Power-Electronics-PCBs-and-Stuff/Wireless-Power-Synchronous-Rectifier/README.md

# Wireless-Power-Synchronous-Rectifier

A 250 kHz wireless-power receiver with a PLL-controlled GaN synchronous rectifier, designed in KiCad 10.
Target output: **67 V / 10 A (~670 W)** into the XT60 output.

> **Status: design in progress — not validated for power operation.** See [Open items](#open-items).

The architecture follows the matched-delay-chain PLL synchronous rectifier described in
*"A Phase-Locked Loop based Multi-MHz Synchronous Rectifier with Inherent Delay Cancellation and ZVS Control"*
(APEC 2027), scaled from the paper's 6.78 MHz prototype down to 250 kHz.

## How it works

1. **Receiver tank** — the receiver coil is series-tuned by C1, C58 and C47. C47 (1 µF) doubles as the
   current-sense capacitor.
2. **Capacitive current sensing** — the voltage across C47 lags the coil current by 90°; the OPA656
   differential integrator (Rf‖Cf = 470k‖68p) adds another −90°, so its output `Is` is in phase with the
   coil current. U3 (TLV3601) squares it into `Is_square`.
3. **PLL** — the SN74LV4046A phase-frequency detector (PC2) compares `Is_square` with `COMPIN` and steers
   the VCO through the R22/R20/C15 loop filter. The VCO output (`pwm`) drives the bridge.
4. **Matched delay chain** — `pwm` drives the real gate drivers (two Si8274GB1) *and* an identical
   "virtual" Si8274GB1 (U1) whose VOB output is squared by a second TLV3601 (U2) into `COMPIN`. Because the
   feedback path uses the same parts as the forward path, their propagation delays cancel.
5. **Synchronous bridge** — four EPC2305 150 V GaN FETs (Q1–Q4) in a full bridge replace the rectifier
   diodes. Output capacitance ≈ 1000 µF.

## Schematic blocks

| Block | Key parts |
|---|---|
| AC input | ReceiverCoil1 (screw terminal), C1/C58 33 nF tuning, C47 1 µF sense cap |
| Rectifier | Q1–Q4 EPC2305 (Q1/Q2 = S1 leg, Q3/Q4 = S2 leg), C19/C27 500 µF bulk, C28–C30/C54 4.7 µF, TP19/22/34–37 |
| Is Ground_Ref (current sense) | IC3 OPA656, 3 × 22k input chains, R43/R44 1k, R45/R46 470k, C4/C5 68p |
| VC comparator | U3 TLV3601, C11 100 nF coupling, 10k bias |
| VCO / PLL | VCO1 SN74LV4046A, C14 2.7 nF, R18 33.2k, R19 6.81k, loop filter R22/R20 3.3k + C15 180 nF |
| S1 / S2 gate drivers | Si8274GB1-IS1R ×2 (single PWM input), 74AHCT1G86 XOR inputs, BAT46W bootstrap diodes, D5/D6 5V1 Zener clamps, R28/R29 15k ‖ 100p dead time (≈38 ns), 3.2 Ω gate resistors |
| Phase shift for COMPIN | U1 Si8274GB1 virtual gate driver (minimum dead time: R7 6.04k ‖ 100p ≈ 20 ns), R10 |
| Feedback to COMPIN | U2 TLV3601 |
| −5 V rail | IC2 LM2776 charge-pump inverter |
| 5 V battery input | BT1 4×AA holder (BC4AAB) → U4 TPS7A2550 5.0 V LDO (C16 1 µF in, C26 2.2 µF out), D3 power LED |
| XT60 output | J1 XT60PW, D4 output-live LED with R13 (doubles as a bleeder for the output caps) |

## Nets to know

| Net | Meaning |
|---|---|
| `S1`, `S2` | Bridge switch nodes (AC input to the rectifier) |
| `Out+` | Rectified DC output |
| `G1`–`G4` | Gate drive for Q1–Q4 |
| `Is`, `Is_square` | Sensed coil current (analog / squared) |
| `FB`, `COMPIN` | Virtual-driver feedback into the PLL |
| `pwm`, `CTRL` | VCO output / VCO control voltage |
| `5V`, `-5V` | Logic rails |

## Libraries

Project-specific symbols and footprints are in `libs/`. Register each in KiCad
(**Preferences → Manage Symbol / Footprint Libraries**), using the folder name as the nickname:

| Part | Symbol | Footprint |
|---|---|---|
| EPC2305 GaN FET | `libs/EPC2305.kicad_sym` | `libs/EPC2305.pretty` |
| TPS7A2550 LDO | `libs/TPS7A25550DRVR.kicad_sym` | `libs/TPS7A25550DRVR.pretty` |
| XT60PW connector | `libs/XT60PW-M.kicad_sym` | `libs/XT60PW-M.pretty` |
| BC4AAB battery holder | `libs/BC4AAB.kicad_sym` | `libs/BC4AAB.pretty` |
| LM2776 | `libs/LM2776DBVR.kicad_sym` | `libs/LM2776DBVR.pretty` |
| Si8274GB1-IS1R gate driver | `libs/SI8274GB1-IS1R.kicad_sym` | stock `Package_SO:SOIC-16_3.9x9.9mm_P1.27mm` |

The EPC2305 symbol is the 15-pin vendor version: all `G_x` pins are the gate, `S_x` the source and
`D_x` the drain (datasheet pads 1 = G, 2/4/6 = S, 3/5/7 = D).

Resistor footprints: 0603 for signal parts; 1206 for parts with high voltage or power across them
(R13 output LED, and the gate resistors if gate drive is raised).

## Open items

- **VCO tuning** — C14/R18/R19 are scaled from the original 13.56 MHz design. Per the CD74HC4046A
  tuning curves, R19 = 6.81k fixes the VCO floor near 600 kHz, so the PLL cannot lock at 250 kHz.
  Proposed values: R19 → 20k, R18 → 13.7k (C14 stays 2.7 nF), loop filter R22 → 9.1k, R20 → 680 Ω,
  C15 → 470 nF. Verify open-loop (step `CTRL` 1.1–4.1 V) before finalizing.
- **Dead time / ZVS** — Si8274 dead time is DT(ns) = 2.02 × R_DT(kΩ) + 7.77, with R_DT 6k–100k. The real
  drivers use 15k (≈38 ns) and the virtual driver 6.04k (≈20 ns); the difference is the paper's ZVS phase
  lead. With the EPC2305's ~103 nC output charge, tune R28/R29 on the bench.
- **Gate drive** — the Si8274 outputs swing to VDDA/VDDB (5 V rail; bootstrap ≈ 4.6 V). It has no internal
  gate clamp, so D5/D6 (5V1 Zener) clamp the bootstrap supply. The EPC2305 gate is rated +6 / −4 V max.
- **Gate pull-downs** — add 10k gate-to-source resistors on Q1–Q4.
- **Comparator bias** — feed U3's + input from the 2.5 V reference (single divider) to remove divider
  mismatch at light load.
- **Receiver interface** — coil inductance assumed 24.68 µH; C1/C58 = 33 nF tune to ~251.5 kHz with
  C47 = 1 µF. Coil and tuning capacitors see ~600 V / ~300 V peak at full load; tuning caps must be
  low-loss film or C0G banks rated for ~11 A RMS. Consider splitting C1/C58 across both coil terminals.
- **Battery** — 4×AA keeps the LDO in regulation only while the pack is above ~5.1 V; 6×AA or a
  buck-boost covers the full discharge.
- **ERC** — remaining errors predate the EPC2305 update (unconnected pins, undriven power pins, missing
  PWR_FLAGs); resolve before layout. R11/R13 still need footprints; set D3/D4 part numbers.
- **PCB** — not started.

## PCB status (2026-11-06)

Update 2026-11-08 (v32, sample cap placement): the S1 tank caps now sit as in `Sample/SynchRectifier_v3`: C58 stacked over
C1 directly above the S1 island with a 4.2 mm pad-to-pad copper zone between them and a 3.4 mm link straight down into the
island; the coil lug moved 6 mm up (board 151 x 83.6 mm). C47 above the S2 copper, the four 4.7 uF bridge caps under the FET
columns on the bottom side, and the driver decoupling directly over/beside the drivers already matched the sample. PLL
passives in two columns beside the 4046 (sample style). KiCad DRC 0/0, 150 vias.

Update 2026-11-08 (v31, clean-up pass): control section re-placed in aligned rows/columns (sense strings in two rows of
four over the OPA656, its bias network in one row, comparator U3 and LDO blocks with their passives in rows, PLL passives in
one bottom-side row under the 4046, U1's passives in one column, test points in rows below the bridge and along the bottom
edge). 5V pads now share one via per decoupling cluster instead of one via per pad (5V vias 40 -> 17, total 188 -> 160);
layer changes cost more in the router. KiCad DRC: 0 violations, 0 unconnected.

Update 2026-11-08 (v30): board shrunk to 151 x 77.6 mm (bottom edge raised, XT60 J1 moved to the left edge next to the
bulk caps, battery holder moved up). The four 4.7 uF bridge caps sit on the bottom side directly under the two FET
columns (two per half bridge) on a dedicated Out+ pour (B/In1/In2) with GND vias beside them. Every signal test point has
a GND test point 3.2 mm away (two pairs share a ground, the G2 pair is 4.3 mm). Routed track corners are mitred to 45 deg
(13 of ~500 corners stay at 90 deg where a mitre would break 0.2 mm clearance). `tools/pcb_build/current_check.py`
tabulates the copper cross-section / IPC-2221 ampacity of every power path (Out+ >= 20 A at 20 degC rise everywhere,
tank >= 16 A except the 2.5 mm C47->S2 link at 20.7 A); `pair_check.py` reports pair lengths, right angles and cap
orientation. KiCad DRC on v30: 0 violations, 0 unconnected (the two vendor footprints were repaired in `libs/`:
IC2 DBV0006A_N centre-cross moved from F.CrtYd to F.Fab, U4 DRV0006A-IPC_A thermal pad 1.1 -> 1.0 mm; vendor '*' and
'Designator' silkscreen texts moved to the Fab layer; R46/C62 designators hidden because no collision-free spot exists).

Update 2026-11-08 (v29): decoupling and bootstrap caps are now placed by `build_pcb.py` against their IC supply pins
(`place_near` / `place_between`, same side as the IC where possible, 1.3-2.5 mm pad-to-pin for the drivers, comparator,
LDO and charge pump; the two Si8274 bootstrap caps straddle VDDA/VSSA with fixed stubs). KiCad DRC unchanged otherwise.

Initial layout generated by `tools/pcb_build/` (see its README): 4 layers, 2 oz outer copper, 151 x 98 mm,
modelled on `Sample/SynchRectifier_v3`. GND pour on all layers except the input/power block, where only targeted
GND islands exist (S1 driver area, low-side FET sources with the 4.7 uF decoupling caps); S1 / S2 / Out+ copper
islands with via arrays under the EPC2305 bridge; 5 mm tank copper; Out+ bus down the left edge to the XT60.
KiCad DRC: 0 unconnected; remaining items are silkscreen text, two library-footprint problems (U4 DRV pad gap,
IC2 open courtyard) and the J1 edge placement (intentional).

Still to do on the PCB: via-in-pad for the EPC2305 bars (fab-dependent), replace the single 1206 tank caps with
the real cap bank and redo that copper, silkscreen cleanup, fix the two footprints, review the kicad-happy EMC
notes (reference-plane gaps are a consequence of the notched GND pour).

## Simulation

LTspice models of the sense chain (`_p1`) and the PLL/VCO loop (`_p2`) are kept in the
`v3_Rectifier_Sims` folder. The p2 model uses a 74HC4046 model as a proxy for the SN74LV4046A; keep the
bridge gates disabled until the PLL locks when simulating.
