Power-Electronics-PCBs-and-Stuff/Wireless-Power-Synchronous-Rectifier/Schematic/Synchronous Rectifier.pdf

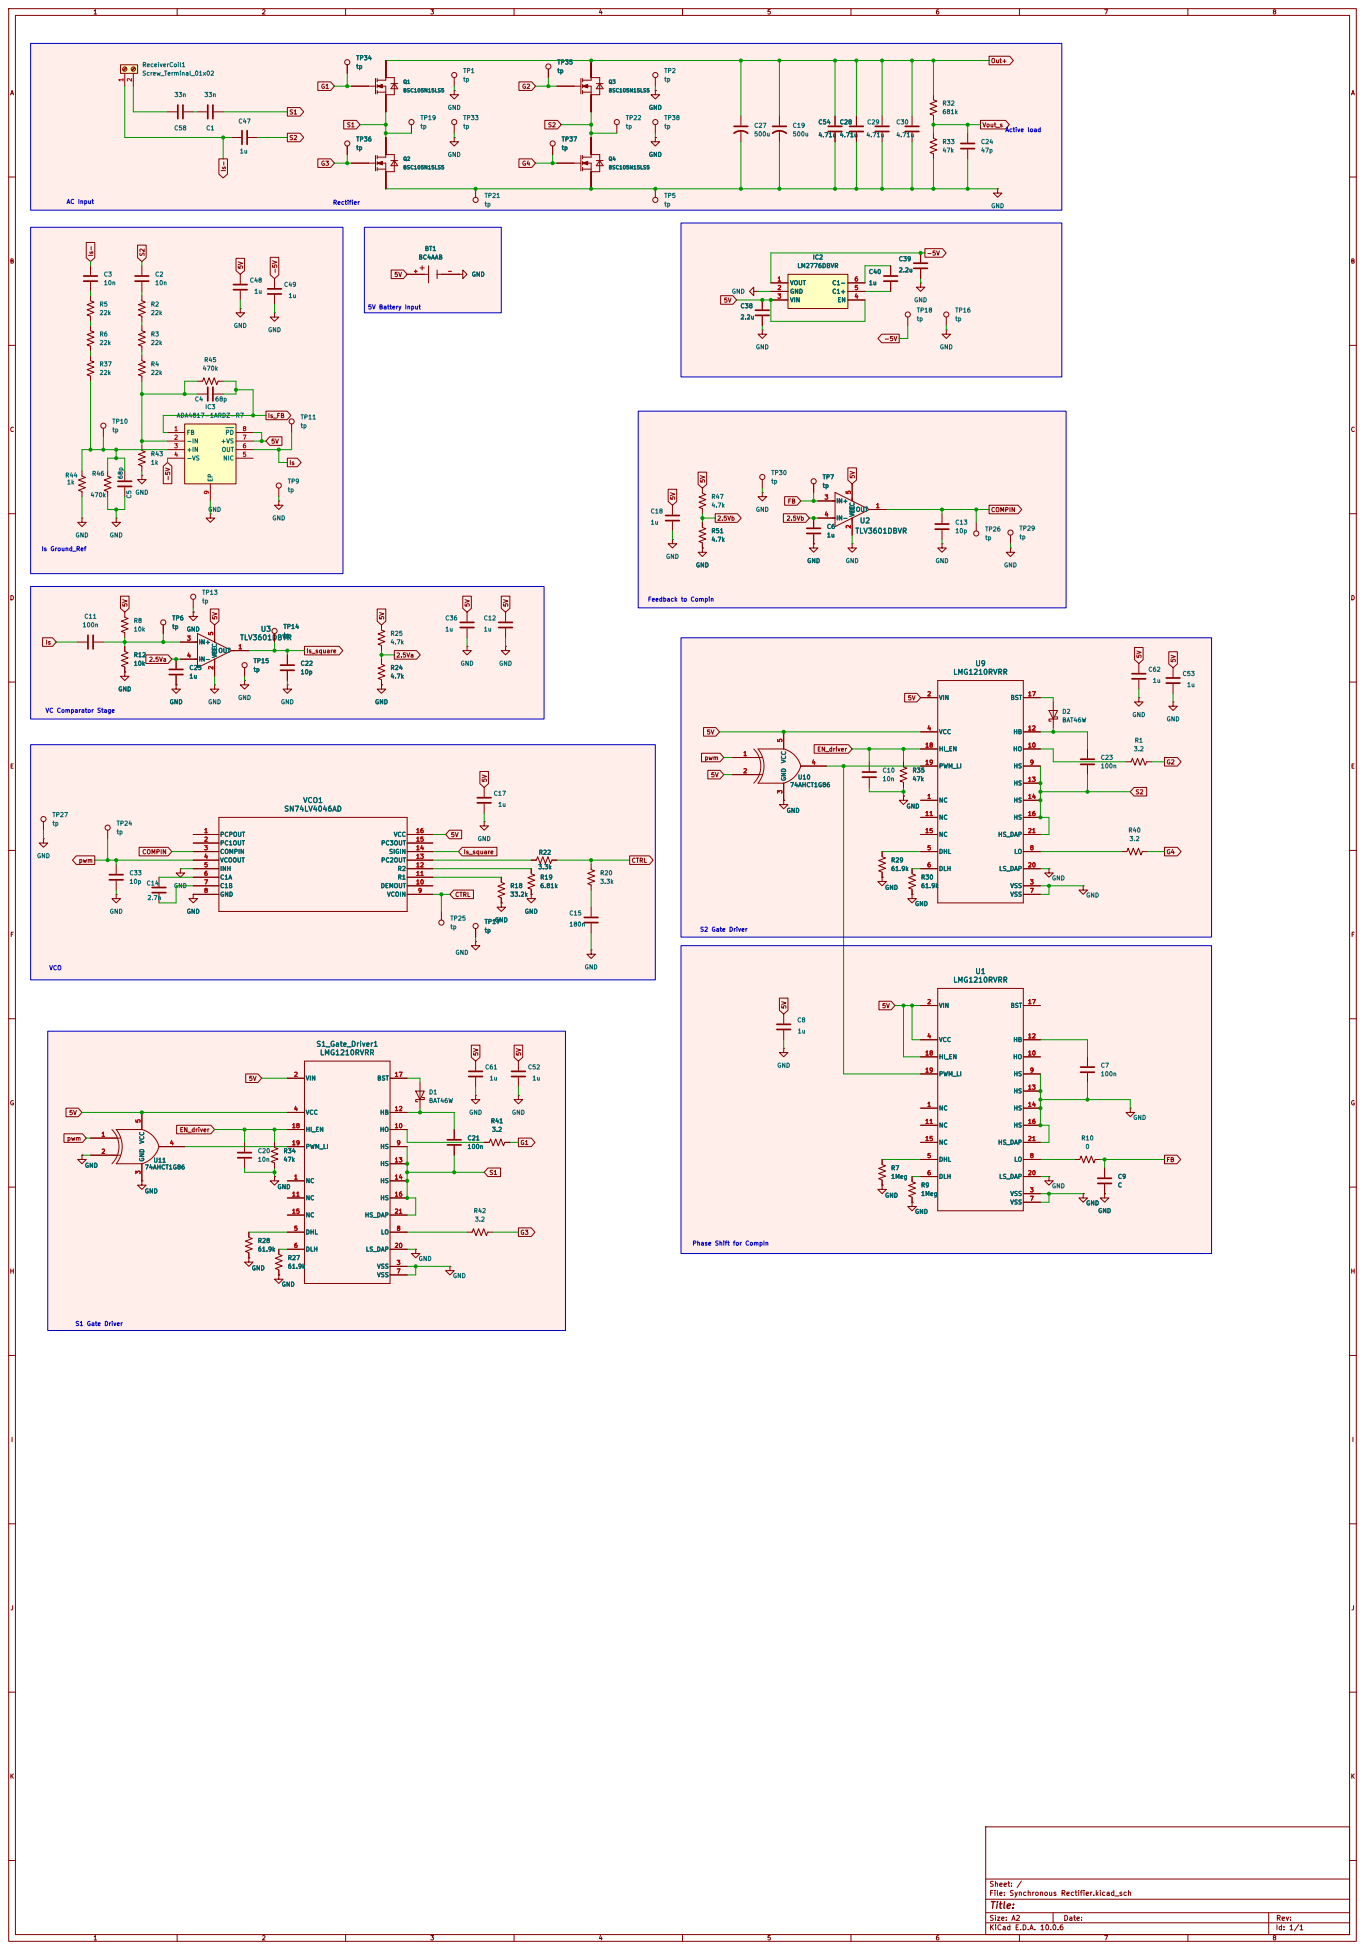
[picture p1: page 1]

Phase Shift for CompIn

Size: A2 | Rev:
KiCad E.D.A. 10.0.6 | Id: 1/1
