Power-Electronics-PCBs-and-Stuff/Wireless-Power-Synchronous-Rectifier/Schematic.pdf

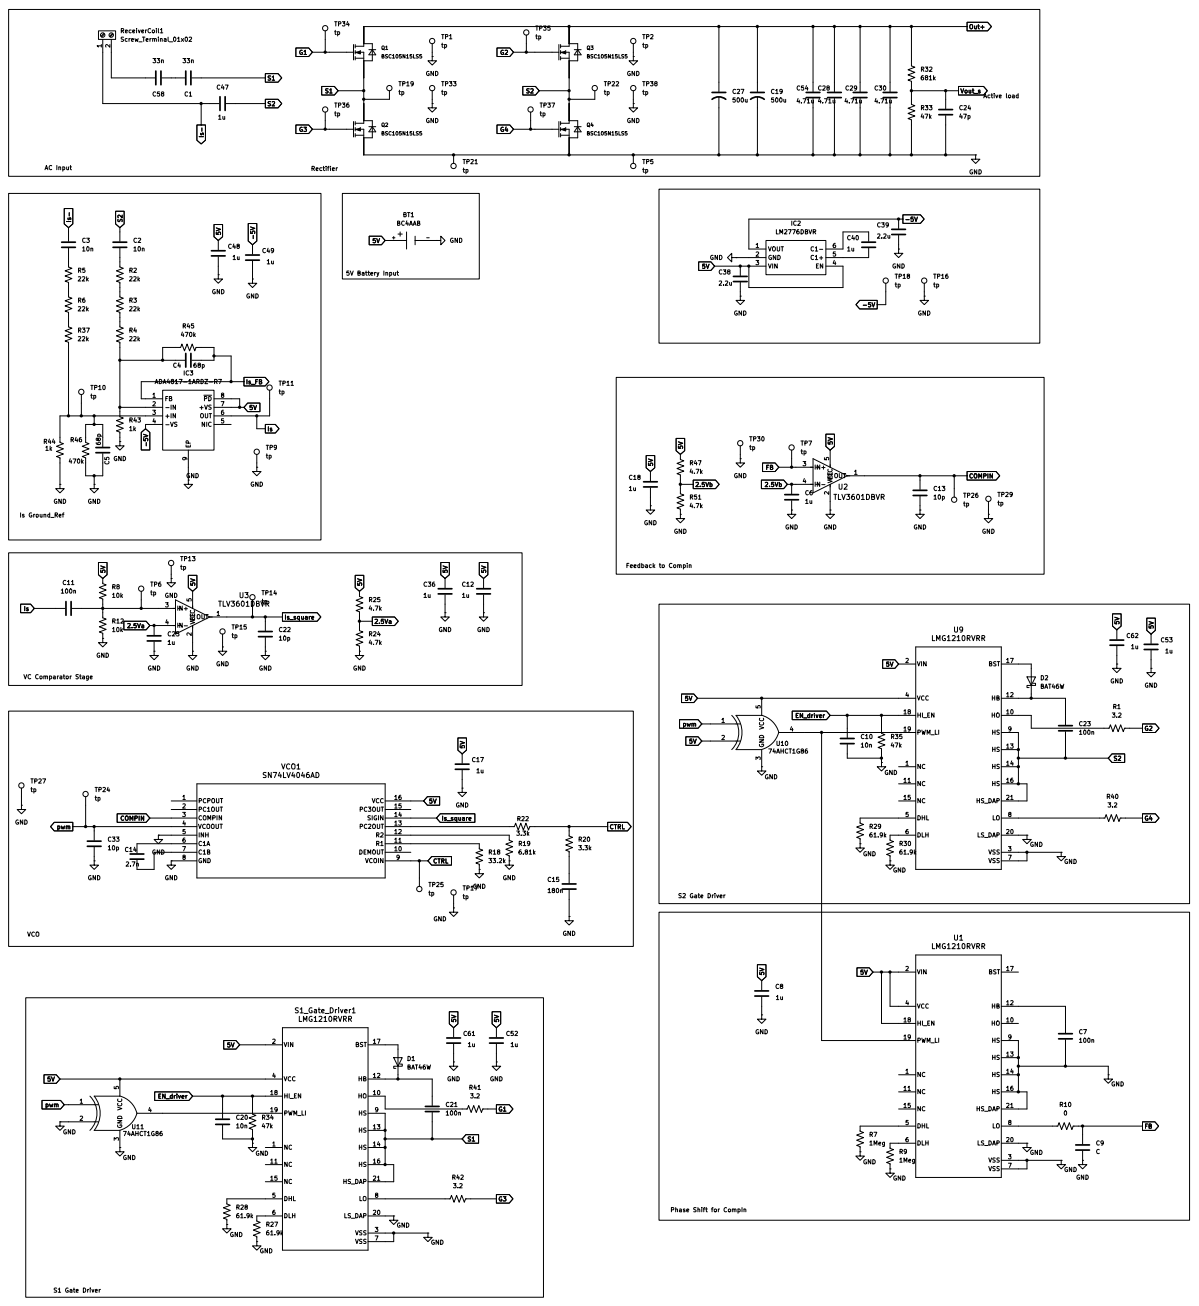
[picture p2: page 1]
