Power-Electronics-PCBs-and-Stuff/Wireless-Power-Synchronous-Rectifier/Synchronous Rectifier.kicad_pcb

## KiCad design Synchronous Rectifier.kicad_pcb (2026-11-10)

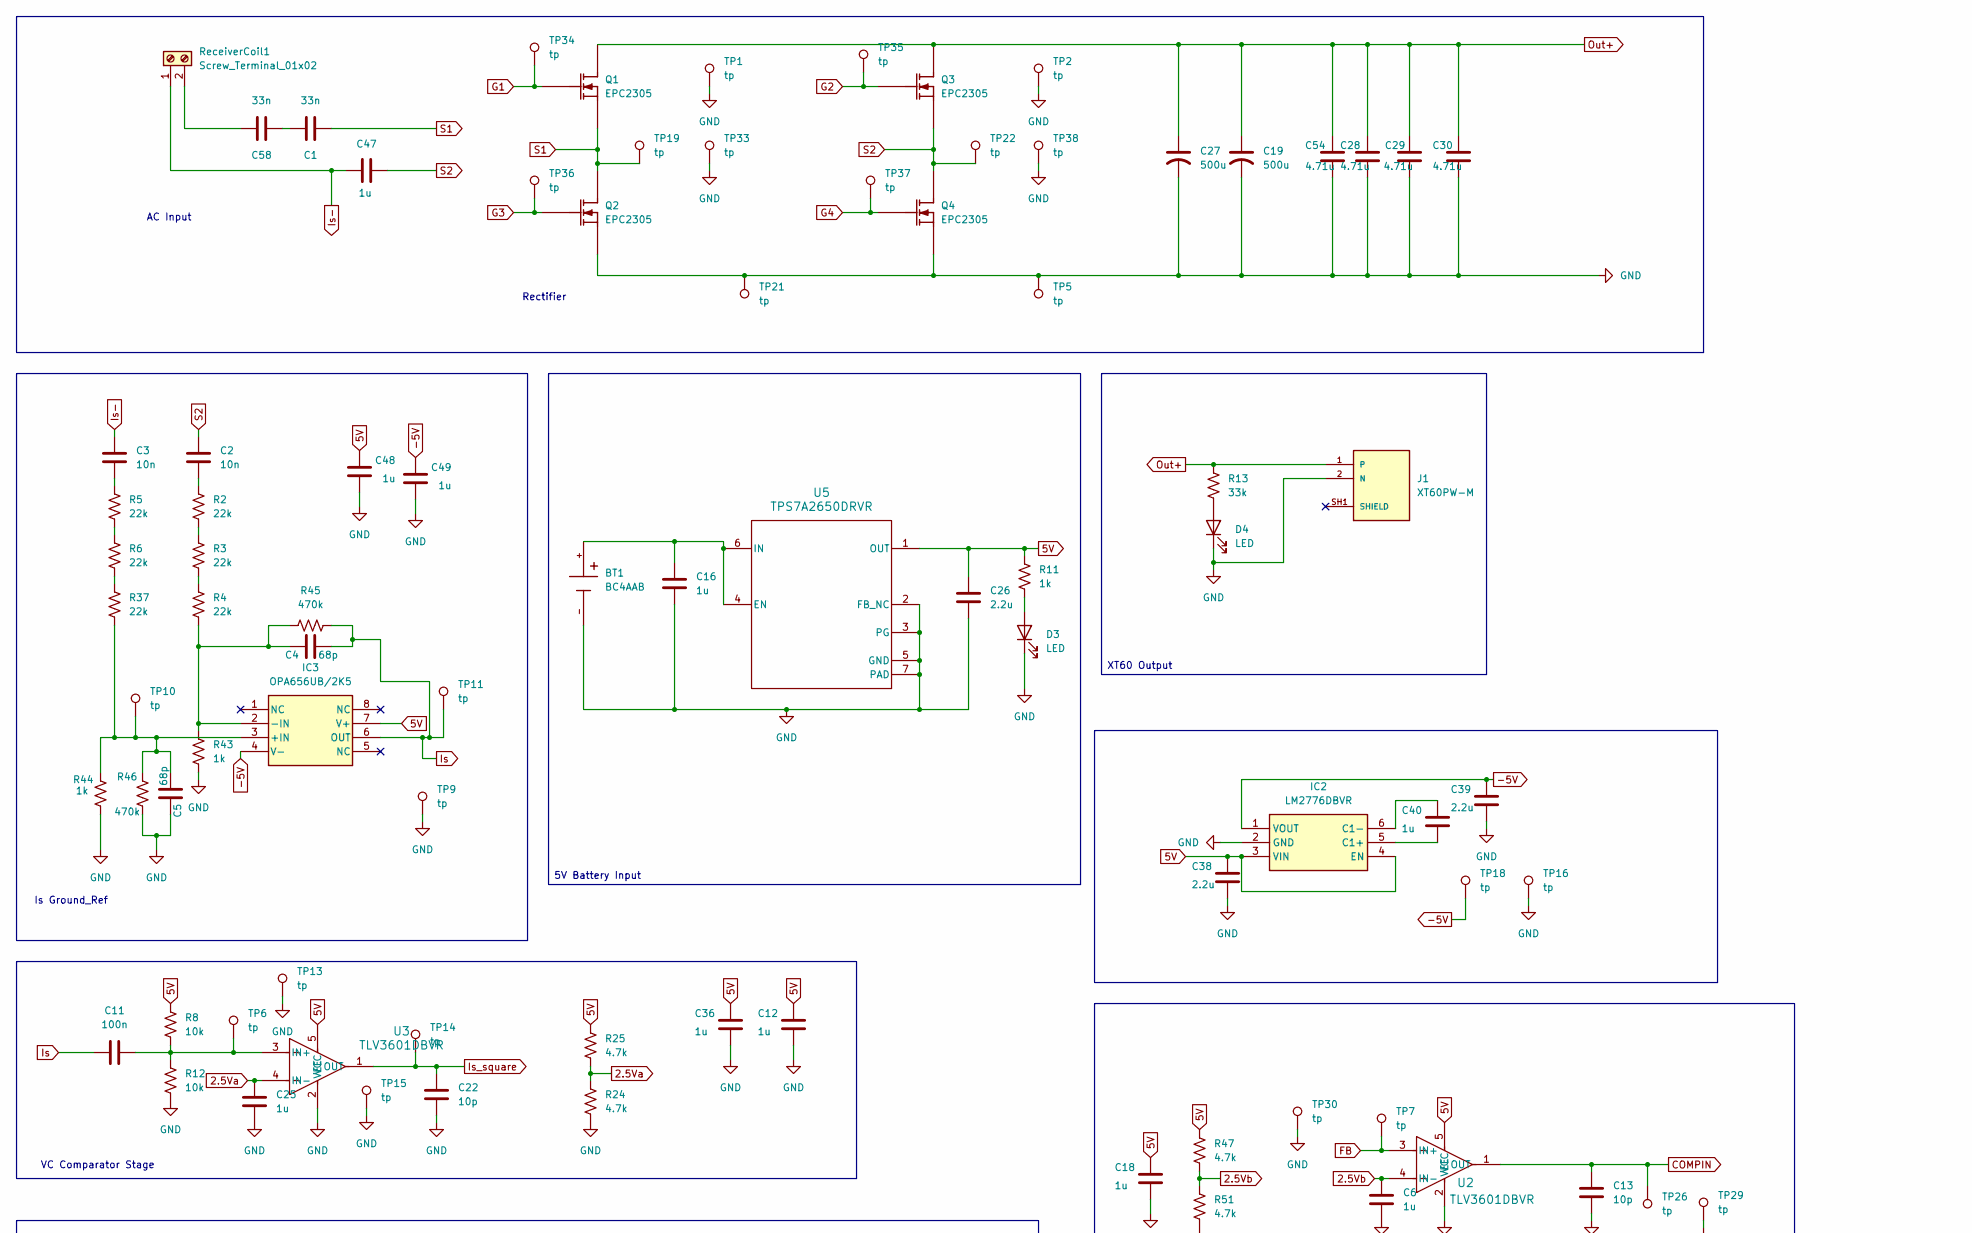
[picture p3: schematic Synchronous Rectifier.kicad_sch, part in row 1, column 1]

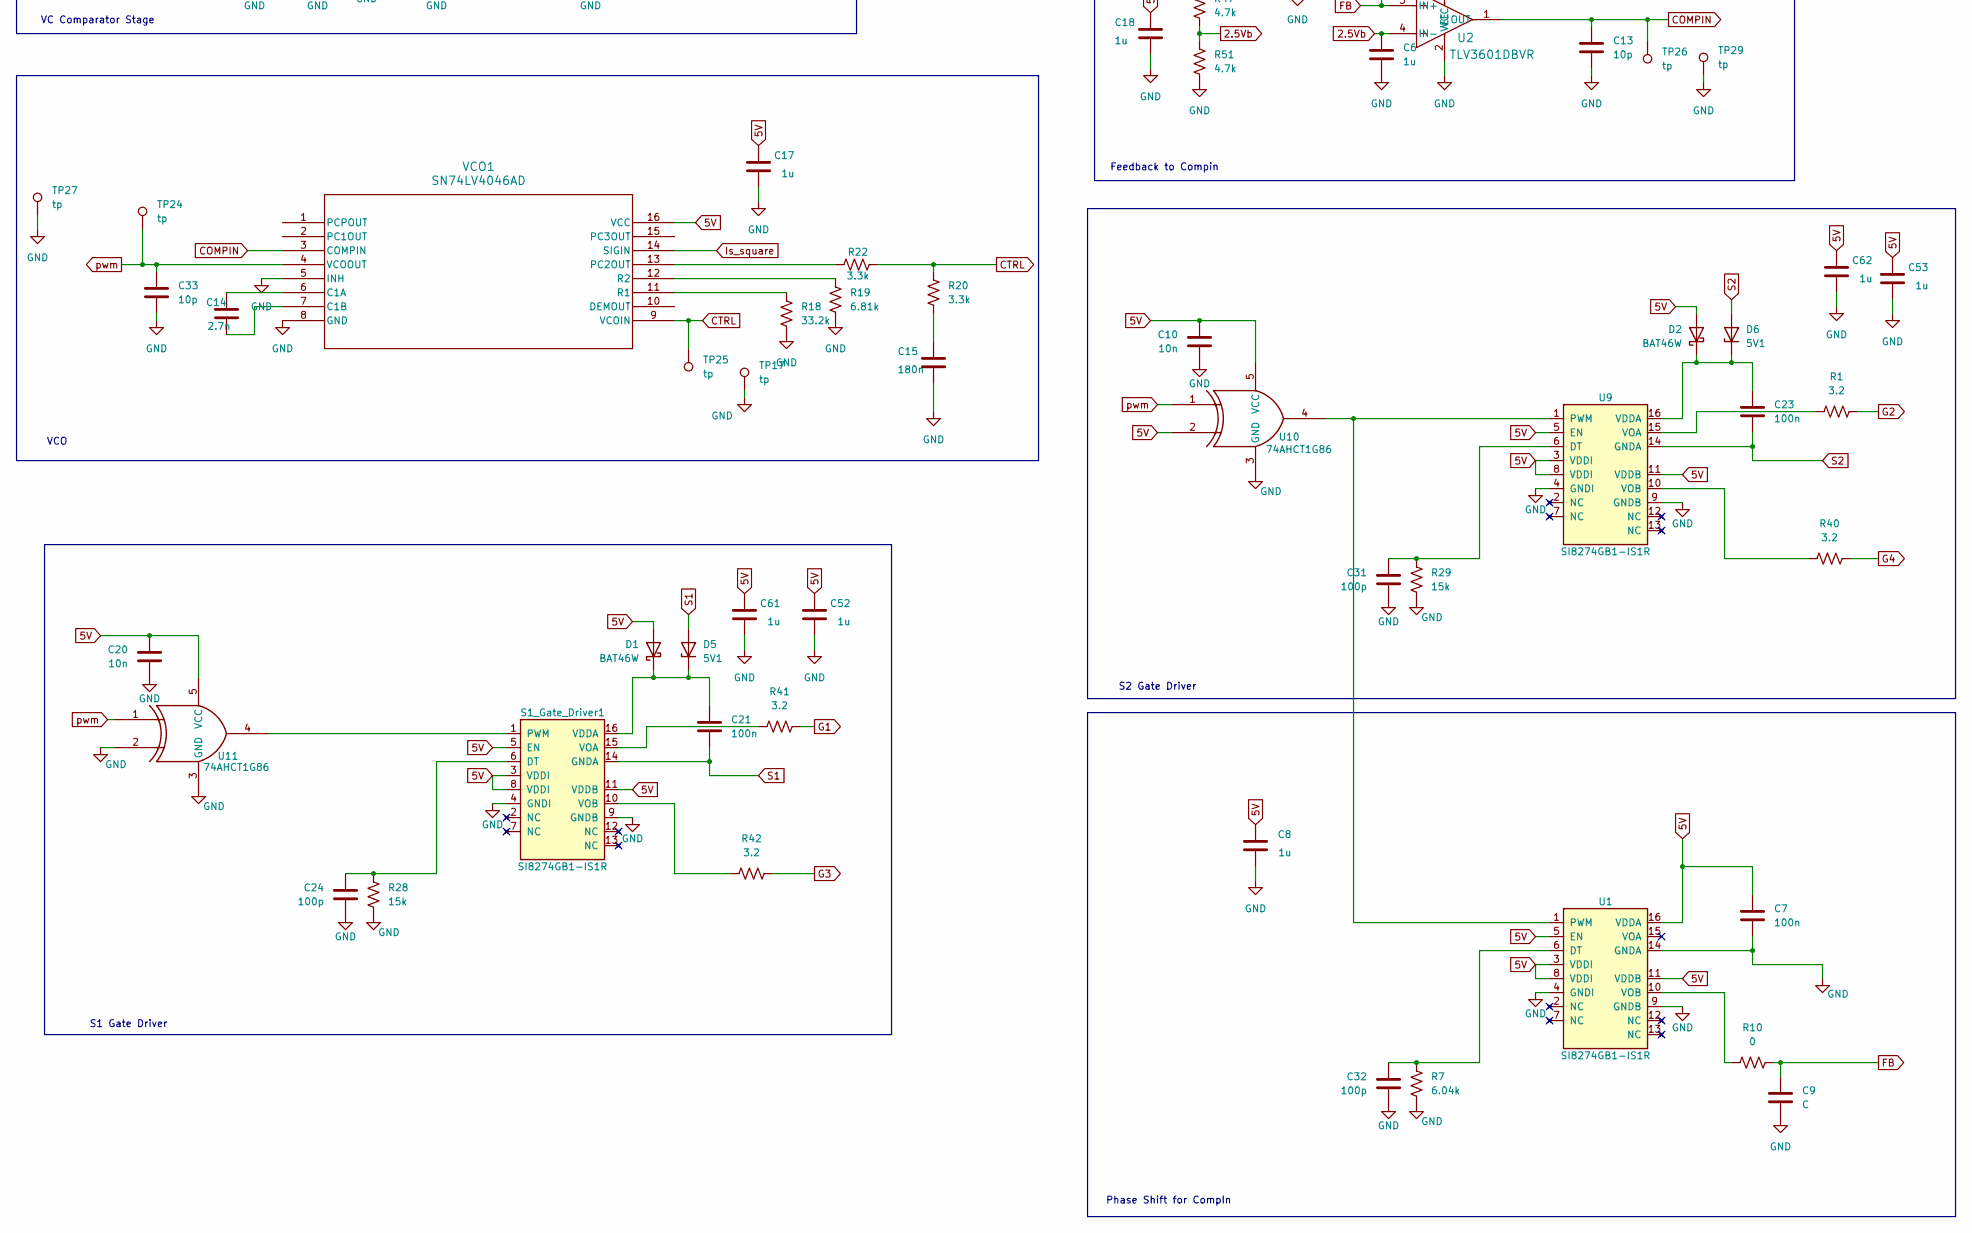
[picture p4: schematic Synchronous Rectifier.kicad_sch, part in row 2, column 1]

Parts:
BT1: BC4AAB; BAT_BC4AAB; PARTREV E; DigiKey_Part_Number BC4AAB-ND
C1, C58: 33n; C_1206_3216Metric
C2, C3, C10, C20: 10n; C_0603_1608Metric
C4, C5: 68p; C_0603_1608Metric
C6, C8, C12, C16, C17, C18, C25, C36, C40, C48, C49, C52, C53, C61, C62: 1u; C_0603_1608Metric
C7, C11, C21, C23: 100n; C_0603_1608Metric
C9: C; C_0603_1608Metric
C13, C22, C33: 10p; C_0603_1608Metric
C14: 2.7n; C_0603_1608Metric
C15: 180n; C_0603_1608Metric
C19, C27: 500u; CP_Radial_D16.0mm_P7.50mm
C24, C31, C32: 100p; C_0603_1608Metric
C26, C38, C39: 2.2u; C_0603_1608Metric
C28, C29, C30, C54: 4.71u; C_1206_3216Metric
C47: 1u; C_1206_3216Metric
D1, D2: BAT46W; D_SOD-123F
D3, D4: LED; LED_0603_1608Metric
D5, D6: 5V1; D_SOD-123; MPN MMSZ5231B
IC2: LM2776DBVR; DBV0006A_N; Mouser Part Number 595-LM2776DBVR
IC3: OPA656UB/2K5; D8; Mouser Part Number 584-ADA4817-1ARDZ-R7
J1: XT60PW-M; AMASS_XT60PW-M; PARTREV 1.2
Q1, Q2, Q3, Q4: EPC2305; Manufacturer_Part_Number EPC2305
R1, R40, R41, R42: 3.2; R_0603_1608Metric
R2, R3, R4, R5, R6, R37: 22k; R_0603_1608Metric
R7: 6.04k; R_0603_1608Metric
R8, R12: 10k; R_0603_1608Metric
R10: 0; R_0603_1608Metric
R11, R43, R44: 1k; R_0603_1608Metric
R13: 33k; R_0603_1608Metric
R18: 33.2k; R_0603_1608Metric
R19: 6.81k; R_0603_1608Metric
R20, R22: 3.3k; R_0603_1608Metric
R24, R25, R47, R51: 4.7k; R_0603_1608Metric
R28, R29: 15k; R_0603_1608Metric
R45, R46: 470k; R_0603_1608Metric
ReceiverCoil1: Screw_Terminal_01x02; Molex_0389690002
S1_Gate_Driver1: SI8274GB1-IS1R; SOIC-16_3.9x9.9mm_P1.27mm; MPN SI8274GB1-IS1R
TP1, TP2, TP5, TP6, TP7, TP9, TP10, TP11, TP13, TP14, TP15, TP16, TP17, TP18, TP19, TP21, TP22, TP24, TP25, TP26, TP27, TP29, TP30, TP33, TP34, TP35, TP36, TP37, TP38: tp; TestPoint_THTPad_D2.0mm_Drill1.0mm
U1, U9: SI8274GB1-IS1R; SOIC-16_3.9x9.9mm_P1.27mm; MPN SI8274GB1-IS1R
U2: TLV3601DBVR; TSOT-23-5_HandSoldering
U3: TLV3601DBVR; SOT-23-5_HandSoldering
U5: TPS7A2650DRVR; DRV0006A_NV
U10, U11: 74AHCT1G86; DBV5
VCO1: SN74LV4046AD; D16

Connections:
2.5Va: C25.2, R24.1, R25.2, U3.4 (IN-)
2.5Vb: C6.2, R47.2, R51.1, U2.4 (IN-)
5V: C7.1, C8.2, C10.1, C12.2, C17.2, C18.2, C20.1, C26.1, C36.2, C38.2, C48.2, C52.2, C53.2, C61.2, C62.2, D1.2 (A), D2.2 (A), IC2.3 (VIN), IC2.4 (EN), IC3.7 (V+), R8.1, R11.1, R25.1, R47.1, S1_Gate_Driver1.3 (VDDI), S1_Gate_Driver1.5 (EN), S1_Gate_Driver1.8 (VDDI), S1_Gate_Driver1.11 (VDDB), U1.3 (VDDI), U1.5 (EN), U1.8 (VDDI), U1.11 (VDDB), U1.16 (VDDA), U2.5 (VCC), U3.5 (VCC), U5.1 (OUT), U9.3 (VDDI), U9.5 (EN), U9.8 (VDDI), U9.11 (VDDB), U10.2, U10.5 (VCC), U11.5 (VCC), VCO1.16 (VCC)
-5V: C39.2, C49.2, IC2.1 (VOUT), IC3.4 (V-), TP18.1 (1_1)
COMPIN: C13.1, TP26.1 (1_1), U2.1 (OUT), VCO1.3 (COMPIN)
CTRL: R20.1, R22.1, TP25.1 (1_1), VCO1.9 (VCOIN)
FB: C9.1, R10.2, TP7.1 (1_1), U2.3 (IN+)
G1: Q1.1 (G_1), Q1.12 (G_2), R41.2, TP34.1 (1_1)
G2: Q3.1 (G_1), Q3.12 (G_2), R1.2, TP35.1 (1_1)
G3: Q2.1 (G_1), Q2.12 (G_2), R42.2, TP36.1 (1_1)
G4: Q4.1 (G_1), Q4.12 (G_2), R40.2, TP37.1 (1_1)
GND: BT1.-, C5.2, C6.1, C7.2, C8.1, C9.2, C10.2, C12.1, C13.2, C15.1, C16.2, C17.1, C18.1, C19.2, C20.2, C22.2, C24.2, C25.1, C26.2, C27.2, C28.1, C29.1, C30.1, C31.2, C32.2, C33.2, C36.1, C38.1, C39.1, C48.1, C49.1, C52.1, C53.1, C54.1, C61.1, C62.1, D3.1 (K), D4.1 (K), IC2.2 (GND), J1.2 (N), Q2.2 (S_1), Q2.4 (S_2), Q2.6 (S_3), Q2.13 (S_4), Q2.14 (S_5), Q2.15 (S_6), Q4.2 (S_1), Q4.4 (S_2), Q4.6 (S_3), Q4.13 (S_4), Q4.14 (S_5), Q4.15 (S_6), R7.2, R12.1, R18.1, R19.1, R24.2, R28.2, R29.2, R43.2, R44.2, R46.1, R51.2, S1_Gate_Driver1.4 (GNDI), S1_Gate_Driver1.9 (GNDB), TP1.1 (1_1), TP2.1 (1_1), TP5.1 (1_1), TP9.1 (1_1), TP13.1 (1_1), TP15.1 (1_1), TP16.1 (1_1), TP17.1 (1_1), TP21.1 (1_1), TP27.1 (1_1), TP29.1 (1_1), TP30.1 (1_1), TP33.1 (1_1), TP38.1 (1_1), U1.4 (GNDI), U1.9 (GNDB), U1.14 (GNDA), U2.2 (VEE), U3.2 (VEE), U5.2 (FB_NC), U5.3 (PG), U5.5 (GND), U5.7 (PAD), U9.4 (GNDI), U9.9 (GNDB), U10.3 (GND), U11.2, U11.3 (GND), VCO1.5 (INH), VCO1.8 (GND)
Is: C4.1, C11.1, IC3.6 (OUT), R45.2, TP11.1 (1_1)
Is-: C3.1, C47.2, ReceiverCoil1.1
Is_square: C22.1, TP14.1 (1_1), U3.1 (OUT), VCO1.14 (SIGIN)
unnamed: C1.1, C58.2
unnamed: C2.2, R2.1
unnamed: C3.2, R5.1
unnamed: C15.2, R20.2
unnamed: C21.1, D1.1 (K), D5.1 (K), S1_Gate_Driver1.16 (VDDA)
unnamed: C23.1, D2.1 (K), D6.1 (K), U9.16 (VDDA)
unnamed: D3.2 (A), R11.2
unnamed: D4.2 (A), R13.2
unnamed: C40.1, IC2.5 (C1+)
unnamed: C40.2, IC2.6 (C1-)
unnamed: C5.1, IC3.3 (+IN), R37.2, R44.1, R46.2, TP10.1 (1_1)
unnamed: C4.2, IC3.2 (-IN), R4.2, R43.1, R45.1
unnamed: R2.2, R3.1
unnamed: R3.2, R4.1
unnamed: R5.2, R6.1
unnamed: R6.2, R37.1
unnamed: C58.1, ReceiverCoil1.2
unnamed: C24.1, R28.1, S1_Gate_Driver1.6 (DT)
unnamed: S1_Gate_Driver1.1 (PWM), U11.4
unnamed: R41.1, S1_Gate_Driver1.15 (VOA)
unnamed: R42.1, S1_Gate_Driver1.10 (VOB)
unnamed: C32.1, R7.1, U1.6 (DT)
unnamed: U1.1 (PWM), U9.1 (PWM), U10.4
unnamed: R10.1, U1.10 (VOB)
unnamed: C11.2, R8.2, R12.2, TP6.1 (1_1), U3.3 (IN+)
unnamed: BT1.+, C16.1, U5.4 (EN), U5.6 (IN)
unnamed: C31.1, R29.1, U9.6 (DT)
unnamed: R1.1, U9.15 (VOA)
unnamed: R40.1, U9.10 (VOB)
unnamed: C14.2, VCO1.6 (C1A)
unnamed: C14.1, VCO1.7 (C1B)
unnamed: R22.2, VCO1.13 (PC2OUT)
unnamed: R18.2, VCO1.11 (R1)
unnamed: R19.2, VCO1.12 (R2)
Out+: C19.1, C27.1, C28.2, C29.2, C30.2, C54.2, J1.1, Q1.3 (D_1), Q1.5 (D_2), Q1.7 (D_3), Q1.8 (D_4), Q1.9 (D_5), Q1.10 (D_6), Q1.11 (D_7), Q3.3 (D_1), Q3.5 (D_2), Q3.7 (D_3), Q3.8 (D_4), Q3.9 (D_5), Q3.10 (D_6), Q3.11 (D_7), R13.1
S1: C1.2, C21.2, D5.2 (A), Q1.2 (S_1), Q1.4 (S_2), Q1.6 (S_3), Q1.13 (S_4), Q1.14 (S_5), Q1.15 (S_6), Q2.3 (D_1), Q2.5 (D_2), Q2.7 (D_3), Q2.8 (D_4), Q2.9 (D_5), Q2.10 (D_6), Q2.11 (D_7), S1_Gate_Driver1.14 (GNDA), TP19.1 (1_1)
S2: C2.1, C23.2, C47.1, D6.2 (A), Q3.2 (S_1), Q3.4 (S_2), Q3.6 (S_3), Q3.13 (S_4), Q3.14 (S_5), Q3.15 (S_6), Q4.3 (D_1), Q4.5 (D_2), Q4.7 (D_3), Q4.8 (D_4), Q4.9 (D_5), Q4.10 (D_6), Q4.11 (D_7), TP22.1 (1_1), U9.14 (GNDA)
pwm: C33.1, TP24.1 (1_1), U10.1, U11.1, VCO1.4 (VCOOUT)

Notes on the sheet:
VCO
S2 Gate Driver
Feedback to Compin
VC Comparator Stage
S1 Gate Driver
Rectifier
Is Ground_Ref
AC Input
Phase Shift for CompIn
XT60 Output
5V Battery Input

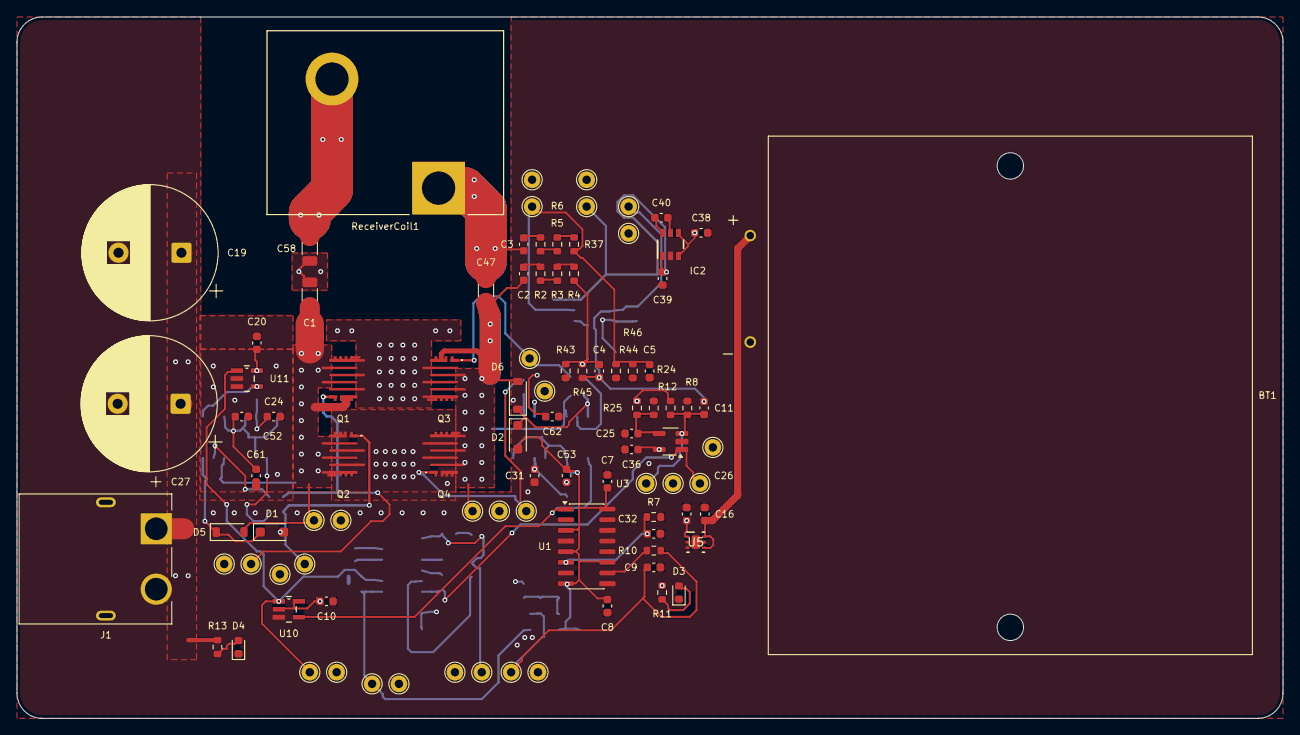
[picture p5: board Synchronous Rectifier.kicad_pcb from above]

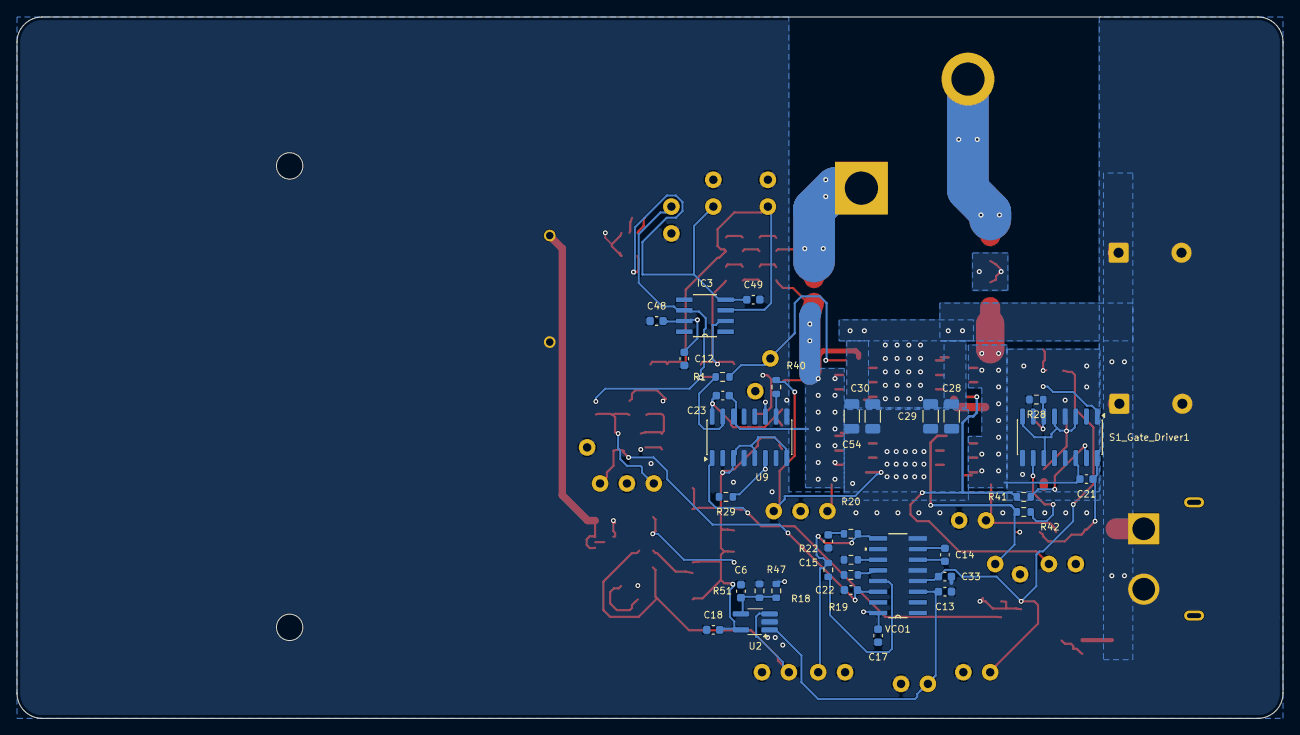
[picture p6: board Synchronous Rectifier.kicad_pcb from below]

Board: 4 copper layers, 150.9 x 83.6 mm, 129 parts (34 on the bottom side), 53 nets.
