Power-Electronics-PCBs-and-Stuff/Wireless-Power-Synchronous-Rectifier/tools/pcb_build/sample_stackup_source.kicad_pcb

## KiCad design tools/pcb_build/sample_stackup_source.kicad_pcb (2026-11-07)

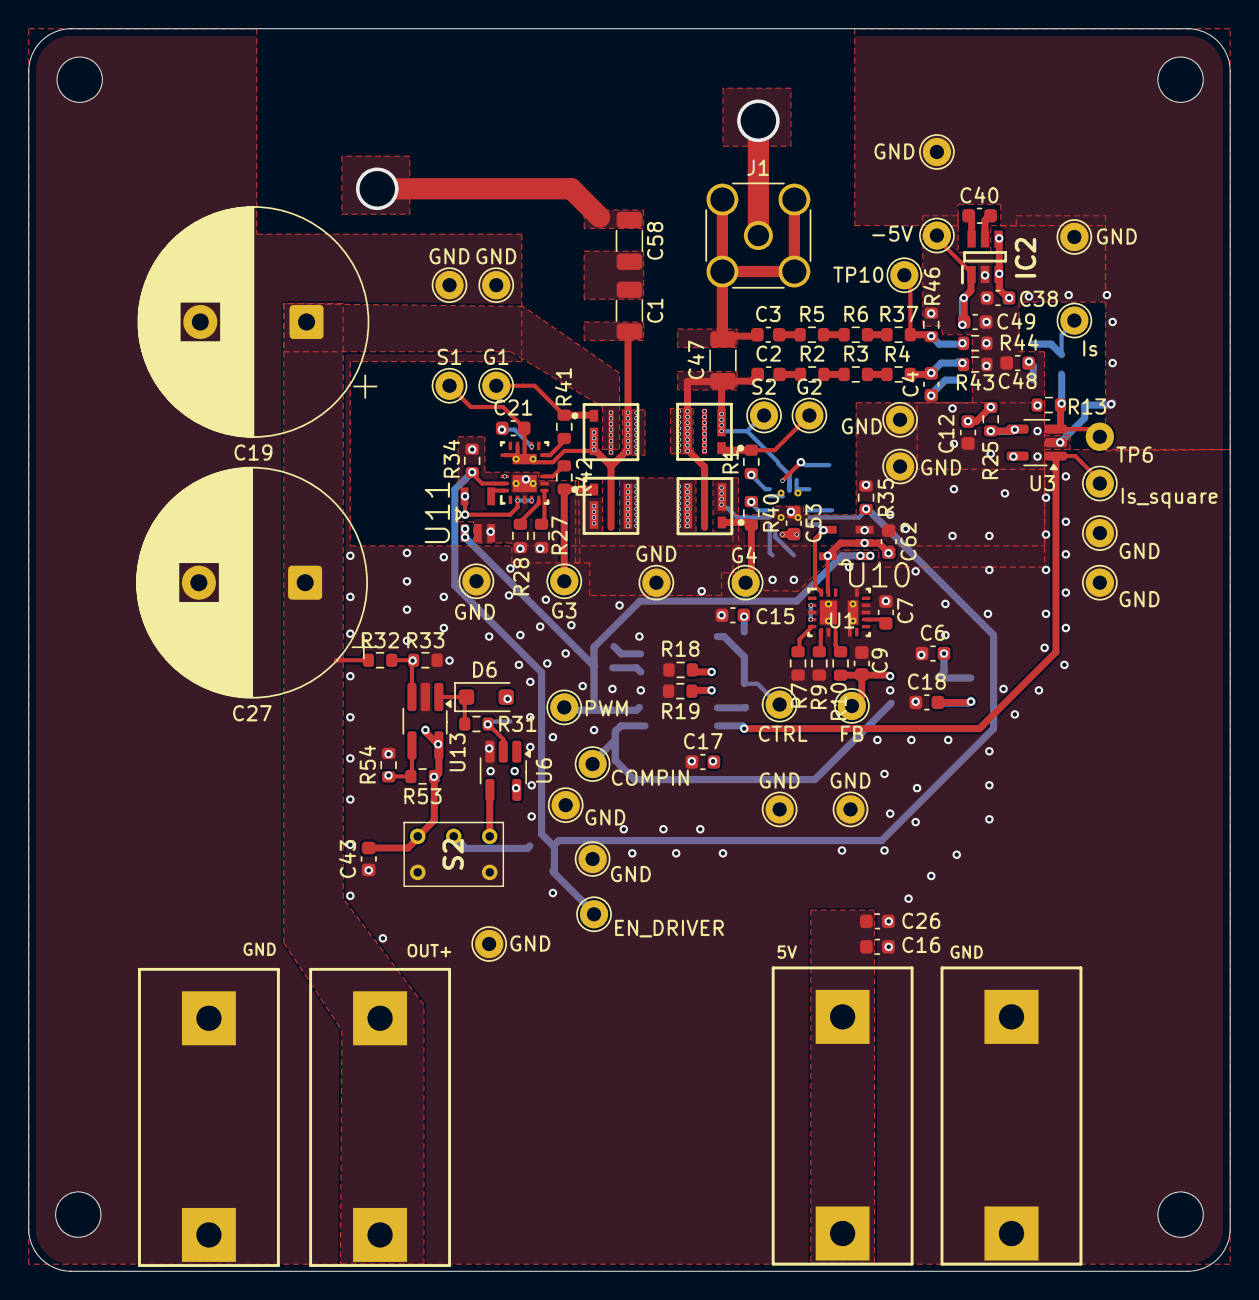
[picture p7: board sample_stackup_source.kicad_pcb from above]

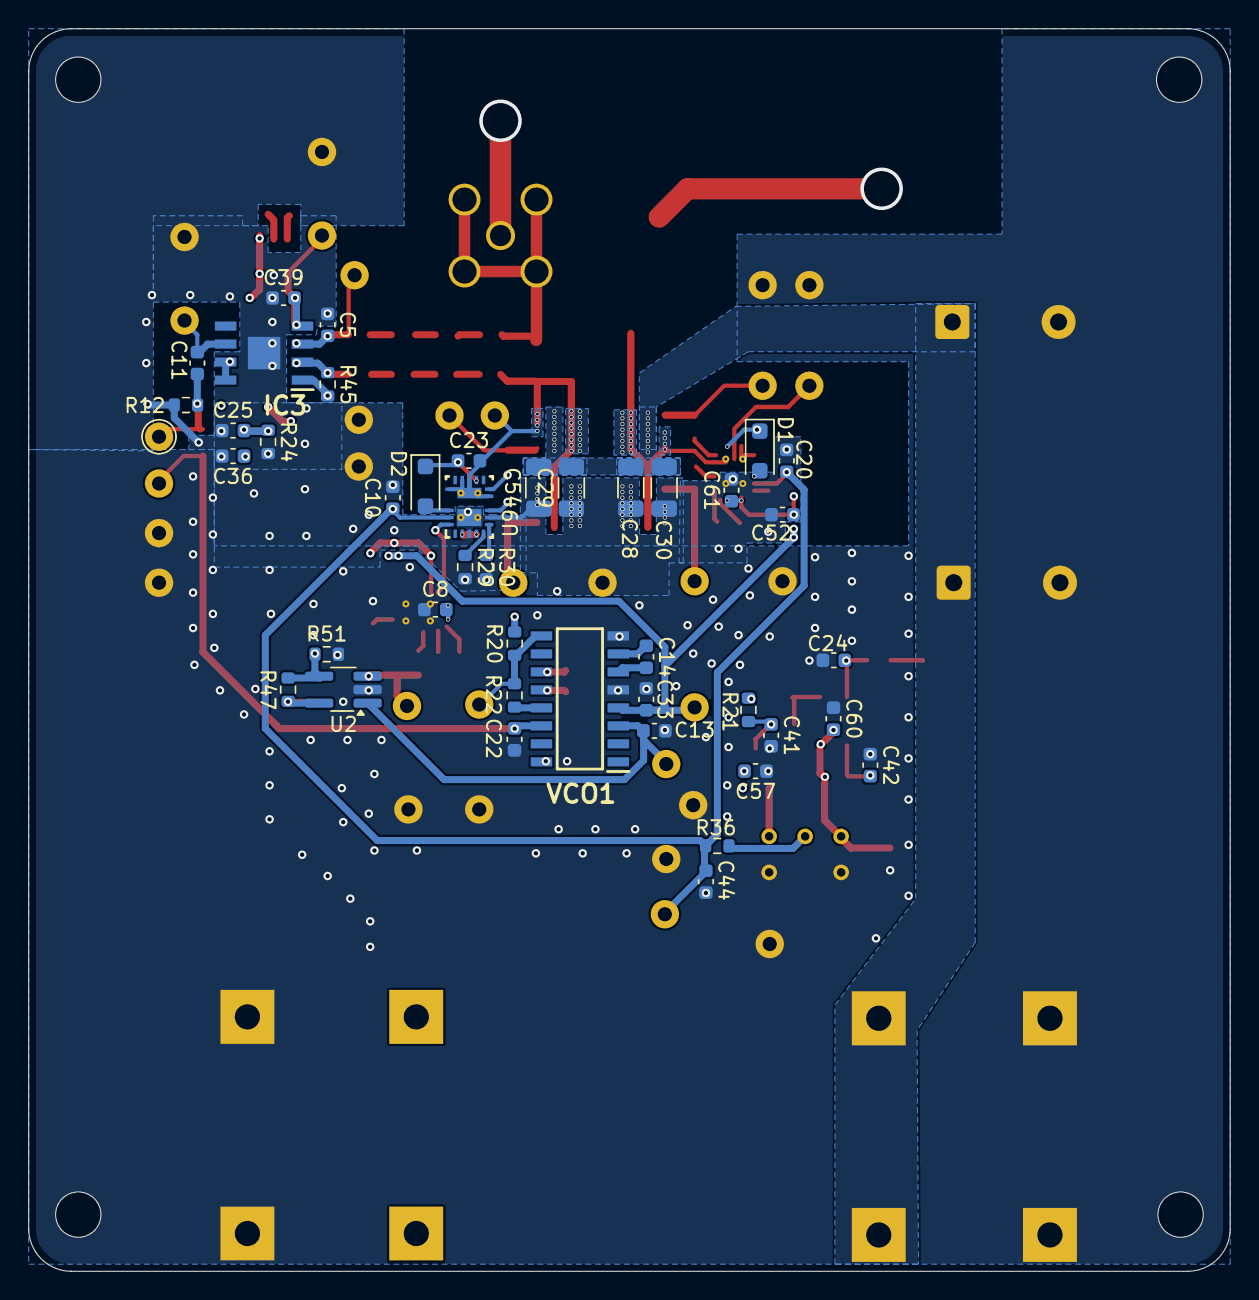
[picture p8: board sample_stackup_source.kicad_pcb from below]

Board: 4 copper layers, 84.8 x 87.7 mm, 146 parts (43 on the bottom side), 64 nets.

Parts:
5V: Conn_Plug_2P; 571-0500
-5V: tp; TestPoint_THTPad_D2.0mm_Drill1.0mm
C1, C58: 1.1n; C_1206_3216Metric
C2, C3, C10, C11, C15, C20, C44: 10n; C_0603_1608Metric
C4, C5: 68p; C_0603_1608Metric
C6, C8, C12, C16, C17, C18, C25, C36, C40, C42, C43, C48, C49, C52, C53, C57, C60, C61, C62: 1u; C_0603_1608Metric
C7, C21, C23, C41: 100n; C_0603_1608Metric
C9: 300p; C_0603_1608Metric
C13, C22, C33: 10p; C_0603_1608Metric
C14: 51p; C_0603_1608Metric
C19, C27: 500u; CP_Radial_D16.0mm_P7.50mm
C24: 47p; C_0603_1608Metric
C26: 10u; C_0603_1608Metric
C28, C29, C30, C54: 10u; C_1206_3216Metric
C38, C39: 2.2u; C_0603_1608Metric
C47: 2.2n; C_1206_3216Metric
COMPIN: tp; TestPoint_THTPad_D2.0mm_Drill1.0mm
CTRL: tp; TestPoint_THTPad_D2.0mm_Drill1.0mm
D1, D2, D6: BAT46W; D_SOD-123F
EN_DRIVER: tp; TestPoint_THTPad_D2.0mm_Drill1.0mm
FB: tp; TestPoint_THTPad_D2.0mm_Drill1.0mm
G1, G2, G3, G4: tp; TestPoint_THTPad_D2.0mm_Drill1.0mm
GND: tp; TestPoint_THTPad_D2.0mm_Drill1.0mm
GND#2, GND#3, GND#4, GND#5, GND#6, GND#8, GND#9, GND#10, GND#11, GND#12, GND#14, GND#15, GND#16, GND#17: tp; TestPoint_THTPad_D2.0mm_Drill1.0mm
GND#7, GND#13: Conn_Plug_2P; 571-0500
IC2: LM2776DBVR; SOT95P280X145-6N
IC3: ADA4817-1ARDZ-R7; SOIC127P600X175-9N
Is: tp; TestPoint_THTPad_D2.0mm_Drill1.0mm
Is_square: tp; TestPoint_THTPad_D2.0mm_Drill1.0mm
J1: Conn_Coaxial; SMA_Amphenol_132134_Vertical
OUT+: Conn_Plug_2P; 571-0500
PWM: tp; TestPoint_THTPad_D2.0mm_Drill1.0mm
Q1, Q2, Q3, Q4: IGB110S10S1; IFX-PG-TSON-4-2-V
R1, R10, R40, R41, R42: 10; R_0603_1608Metric
R2, R3, R4, R5, R6, R24, R25, R37, R47, R51, R53, R54: 4.7k; R_0603_1608Metric
R7, R9: 1.78Meg; R_0603_1608Metric
R12, R13, R20, R22, R43, R44: 1k; R_0603_1608Metric
R18: 32.4k; R_0603_1608Metric
R19: 18.7K; R_0603_1608Metric
R21: 100; R_0603_1608Metric
R27, R28, R29, R30: 60.4K; R_0603_1608Metric
R31: 100k; R_0603_1608Metric
R32: 681k; R_0603_1608Metric
R33, R34, R35: 47k; R_0603_1608Metric
R36: 470; R_0603_1608Metric
R45, R46: 14.7k; R_0603_1608Metric
S1, S2: tp; TestPoint_THTPad_D2.0mm_Drill1.0mm
S1_Gate_Driver1: LMG1210RVRR; RVR0019A
S2#2: G13AP
TP6, TP10: tp; TestPoint_THTPad_D2.0mm_Drill1.0mm
U1, U9: LMG1210RVRR; RVR0019A
U2, U13: TLV3601DBVR; TSOT-23-5_HandSoldering
U3: TLV3601DBVR; SOT-23-5_HandSoldering
U6: 74LVC1G17; SOT-23-5_HandSoldering
U10, U11: 74AHCT1G86; SOT95P280X145-5N
VCO1: SN74LV4046AD; SOIC127P600X175-16N

Connections:
2.5Va: C25.2, R24.1, R25.2, U3.4 (IN-)
2.5Vb: C6.2, R47.2, R51.1, U2.4 (IN-)
2.5Vc: C42.2, R53.2, R54.1, U13.4 (IN-)
5V: 5V.1 (L), 5V.2 (N), C8.2, C12.2, C16.2, C17.2, C18.2, C26.2, C36.2, C38.2, C43.2, C48.2, C52.2, C53.2, C57.2, C60.2, C61.2, C62.2, IC2.3 (VIN), IC2.4 (EN), IC3.7 (+VS), IC3.8 (~PD), R13.2, R25.1, R47.1, R53.1, S1_Gate_Driver1.2 (VIN), S1_Gate_Driver1.4 (VCC), S2#2.6 (NC), U1.2 (VIN), U1.4 (VCC), U1.18 (HI_EN), U2.5 (VCC), U3.5 (VCC), U6.5 (VCC), U9.2 (VIN), U9.4 (VCC), U10.2, U10.5 (VCC), U11.5 (VCC), U13.5 (VCC), VCO1.16 (VCC)
-5V: -5V.1, C39.2, C49.2, IC2.1 (VOUT), IC3.4 (-VS)
COMPIN: C13.1, COMPIN.1, U2.1 (OUT), VCO1.3 (COMPIN)
CTRL: CTRL.1, R20.1, R22.1, VCO1.9 (VCOIN)
EN_driver: C10.1, C20.1, C44.1, EN_DRIVER.1, R34.2, R35.2, R36.2, S1_Gate_Driver1.18 (HI_EN), U9.18 (HI_EN)
FB: C9.1, FB.1, R10.2, U2.3 (IN+)
G1: G1.1, Q1.1 (G), R41.2
G2: G2.1, Q3.1 (G), R1.2
G3: G3.1, Q2.1 (G), R42.2
G4: G4.1, Q4.1 (G), R40.2
GND: C5.2, C6.1, C7.2, C8.1, C9.2, C10.2, C12.1, C13.2, C15.1, C16.1, C17.1, C18.1, C19.2, C20.2, C22.2, C24.2, C25.1, C26.1, C27.2, C28.1, C29.1, C30.1, C33.2, C36.1, C38.1, C39.1, C41.2, C42.1, C43.1, C44.2, C48.1, C49.1, C52.1, C53.1, C54.1, C57.1, C60.1, C61.1, C62.1, GND.1, GND#2.1, GND#3.1, GND#4.1, GND#5.1, GND#6.1, GND#7.1 (L), GND#7.2 (N), GND#8.1, GND#9.1, GND#10.1, GND#11.1, GND#12.1, GND#13.1 (L), GND#13.2 (N), GND#14.1, GND#15.1, GND#16.1, GND#17.1, IC2.2 (GND), IC3.9 (EP), Q2.3 (S1), Q2.4 (S2), Q4.3 (S1), Q4.4 (S2), R7.2, R9.2, R12.1, R18.1, R19.1, R24.2, R27.2, R28.2, R29.2, R30.2, R33.1, R34.1, R35.1, R43.2, R44.2, R46.1, R51.2, R54.2, S1_Gate_Driver1.3 (VSS), S1_Gate_Driver1.7 (VSS), S1_Gate_Driver1.20 (LS_DAP), S2#2.MH1, S2#2.MH2, U1.3 (VSS), U1.7 (VSS), U1.9 (HS), U1.13 (HS), U1.14 (HS), U1.16 (HS), U1.20 (LS_DAP), U1.21 (HS_DAP), U2.2 (VEE), U3.2 (VEE), U6.3 (GND), U9.3 (VSS), U9.7 (VSS), U9.20 (LS_DAP), U10.3 (GND), U11.2, U11.3 (GND), U13.2 (VEE), VCO1.5 (INH), VCO1.8 (GND)
Is: C11.1, IC3.6 (OUT), Is.1
Is-: C3.1, C47.2, J1.2 (Ext)
Is_FB: C4.1, IC3.1 (FB), R45.2
Is_square: C22.1, Is_square.1, U3.1 (OUT), VCO1.14 (SIGIN)
unnamed: C1.1, C58.2
unnamed: C2.2, R2.1
unnamed: C3.2, R5.1
unnamed: C15.2, R20.2
unnamed: C41.1, R21.2, R31.2, U6.2
unnamed: D1.2 (A), S1_Gate_Driver1.17 (BST)
unnamed: C21.1, D1.1 (K), S1_Gate_Driver1.12 (HB)
unnamed: D2.2 (A), U9.17 (BST)
unnamed: C23.1, D2.1 (K), U9.12 (HB)
unnamed: D6.2 (A), R21.1
unnamed: D6.1 (K), R31.1, U13.1 (OUT)
unnamed: C40.1, IC2.5 (C1+)
unnamed: C40.2, IC2.6 (C1-)
unnamed: C5.1, IC3.3 (+IN), R37.2, R44.1, R46.2, TP10.1
unnamed: C4.2, IC3.2 (-IN), R4.2, R43.1, R45.1
unnamed: R2.2, R3.1
unnamed: R3.2, R4.1
unnamed: R5.2, R6.1
unnamed: R6.2, R37.1
unnamed: R28.1, S1_Gate_Driver1.5 (DHL)
unnamed: R27.1, S1_Gate_Driver1.6 (DLH)
unnamed: R41.1, S1_Gate_Driver1.10 (HO)
unnamed: R42.1, S1_Gate_Driver1.8 (LO)
unnamed: S1_Gate_Driver1.19 (PWM_LI), U11.4
unnamed: R36.1, S2#2.5 (COM)
unnamed: S2#2.4 (NO), U6.4
unnamed: R7.1, U1.5 (DHL)
unnamed: R9.1, U1.6 (DLH)
unnamed: C7.1, U1.12 (HB)
unnamed: R10.1, U1.8 (LO)
unnamed: U1.19 (PWM_LI), U9.19 (PWM_LI), U10.4
unnamed: C11.2, R12.2, R13.1, TP6.1, U3.3 (IN+)
unnamed: R29.1, U9.5 (DHL)
unnamed: R30.1, U9.6 (DLH)
unnamed: R1.1, U9.10 (HO)
unnamed: R40.1, U9.8 (LO)
unnamed: C14.2, VCO1.6 (C1A)
unnamed: C14.1, VCO1.7 (C1B)
unnamed: R22.2, VCO1.13 (PC2OUT)
unnamed: R18.2, VCO1.11 (R1)
unnamed: R19.2, VCO1.12 (R2)
Out+: C19.1, C27.1, C28.2, C29.2, C30.2, C54.2, OUT+.1 (L), OUT+.2 (N), Q1.2 (D), Q3.2 (D), R32.2
S1: C1.2, C21.2, Q1.3 (S1), Q1.4 (S2), Q2.2 (D), S1.1, S1_Gate_Driver1.9 (HS), S1_Gate_Driver1.13 (HS), S1_Gate_Driver1.14 (HS), S1_Gate_Driver1.16 (HS), S1_Gate_Driver1.21 (HS_DAP)
S2: C2.1, C23.2, C47.1, Q3.3 (S1), Q3.4 (S2), Q4.2 (D), S2.1, U9.9 (HS), U9.13 (HS), U9.14 (HS), U9.16 (HS), U9.21 (HS_DAP)
Vout_s: C24.1, R32.1, R33.2, U13.3 (IN+)
pwm: C33.1, PWM.1, U10.1, U11.1, VCO1.4 (VCOOUT)
