Power-Electronics-PCBs-and-Stuff/Wireless-Power-Synchronous-Rectifier/(commit log)

2026-10-25 first round changes, before ltspice
    [Synchronous Rectifier.kicad_sch]
2026-10-25 setup 2 ltspice, need to update resistors based on graphs
    [Synchronous Rectifier.kicad_sch]
2026-11-01 mostly done schematic, need to update sims, need to add ganfets
    [Synchronous Rectifier.kicad_sch]
2026-11-02 added ganfets
    [Synchronous Rectifier.kicad_sch]
2026-11-05 updated libraries, before sold out parts
    [Synchronous Rectifier.kicad_sch]
2026-11-05 other stuff, before updating op amp and gate driver
2026-11-05 new op amp I sense, lib for new gate driver
    [Synchronous Rectifier.kicad_sch]
2026-11-05 updated gate driver
    [Synchronous Rectifier.kicad_sch]
2026-11-07 just kill me
    [Synchronous Rectifier.kicad_pcb, Synchronous Rectifier.kicad_sch, sample_stackup_source.kicad_pcb]
2026-11-08 v29 with cap stuff
    [Synchronous Rectifier.kicad_pcb]
2026-11-08 angles, diffy signals, test points, caps
    [Synchronous Rectifier.kicad_pcb]
2026-11-08 fixed drc
    [Synchronous Rectifier.kicad_pcb]
2026-11-08 fixed everything
    [Synchronous Rectifier.kicad_pcb]
2026-11-09 small changes
    [Synchronous Rectifier.kicad_pcb]
2026-11-10 bom and new ldo
    [Synchronous Rectifier.kicad_pcb, Synchronous Rectifier.kicad_sch, bom.csv, order_digikey.csv]
